fablab-bergamo/contatore-geiger/3d-enclosure/Case.stl

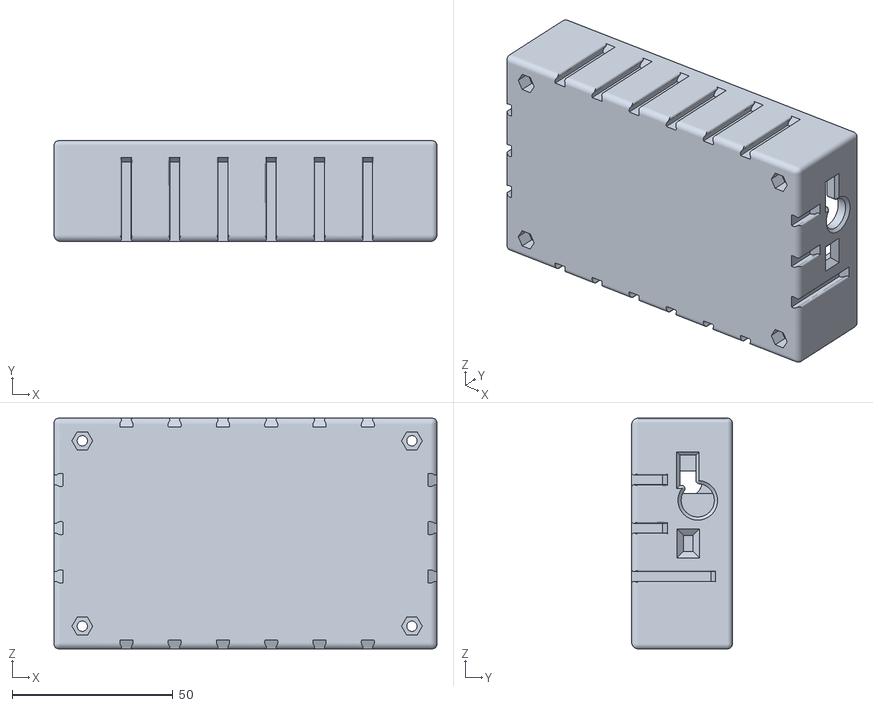
[picture p4: CAD file, 2026-03-28]
3d-enclosure/Case.stl
119.0 x 31.3 x 71.7
