fablab-bergamo/contatore-geiger/measurements/grafico radiazione - distanza.pdf

Sheet1

Page 1

Distanza (m) Radiazione (uSv/h) | Distanza | 1/Distanza ^ 2 | Radiazione (uSv/h)
1 | 0.13 | 1 | 1.00 | 0.13
0.6 | 0.26 | 0.6 | 2.78 | 0.26
0.5 | 0.39 | 0.5 | 4.00 | 0.39
0.3 | 1.14 | 0.3 | 11.11 | 1.14
0.25 | 1.64 | 0.25 | 16.00 | 1.64
0.15 | 6.08 | 0.15 | 44.44 | 6.08
0.1 | 0.2 | 0.3 | 0.4 | 0.5 | 0.6 | 0.7 | 0.8 | 0.9 | 1 | 1.1

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
0.00 5.00 10.00 15.00 20.00 25.00 30.00 35.00 40.00 45.00 50.00

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
Radiazione (uSv/h)

Sheet1

Page 2
